spzyh/NFC-/制造文件/小圆/BOM_PCB_NFC通信_2021-12-02.csv

ID | Name | Designator | Footprint | Quantity | Manufacturer Part | Manufacturer | Supplier | Supplier Part | Price
1 | LED-0603_G | LED1 | LED0603_GREEN | 1 | 19-217/GHC-YR1S2/3T | EVERLIGHT(台湾亿光) | LCSC | C72043 | 0.1652
2 | NFC_ANTENNA | A1 | NFC天线 | 1 |  |  | Z
3 | 220nF | C1 | C0603 | 1
4 | 10k | R1 | R0603 | 1
5 | NT3H1101W0FHKH | U1 | XQFN-8_L1.6-W1.6-P0.50-BR | 1 | NT3H1101W0FHKH | NXP Semicon | LCSC | C73156 | 9.24
