spzyh/NFC-/(list of files, drawings)

Other design files:
工程文件/AD/PCB_NFC通信_小圆_2021-12-08.pcbdoc
工程文件/AD/Sheet_1_2021-12-08.schdoc
工程文件/立创EDA/PCB_PCB_NFC通信_小圆_2021-12-08.json
工程文件/立创EDA/SCH_NFC通信_2021-12-08.json
